richfelker/delta-ballcup/(commit log)

2025-03-15 initial check-in, matching early-access version of the ball-cup file
    [ballcupend.scad]
2025-03-15 fix wrong parameterizations in terms of custom ball cup outer diameter
    aside from the sqrt(2) term, where the old value was very close and
    should have matched but was probably a sloppy empirical determination,
    these changes should not affect the output with the existing default
    od=13.
    [ballcupend.scad]
2025-03-15 make thickness of coverage below ball customizable as angle
    [ballcupend.scad]
2025-03-15 revert cutout parameterization on ball diameter, use fixed value for now
    this will be changed to a proper parameterization, but to start off
    with and have a good point of reference, get rid of the wrong one.
    [ballcupend.scad]
2025-03-15 parameterize clearance cut slope on arm offset and start offset
    [ballcupend.scad]
2025-03-15 add chamfers to end of arm sleeve and arm tube insertion hole
    [ballcupend.scad]
2025-03-15 fixup seam cut above equator
    with a shallow slope, the toroidal seam cut, which doesn't follow the
    cylinder it's cutting, diminishes significantly near the top. add a
    straight one that follows the cylinder.
    this is mainly an aesthetic improvement; the affected part of the seam
    is not a contact point with the ball.
    [ballcupend.scad]
2025-03-15 factor seam cut to module
    [ballcupend.scad]
2025-03-15 round the edge of the seam cut in the cup
    this makes it so not only the seam print quality, but also any
    pressure advance tuning issues, should be irrelevant to the part of
    the cup that comes in contact with the ball.
    the profile used is not perfect because of how it meets the spherical
    curvature of the ball. this is what the 0.9 fudge factor is there for.
    it should be fine for anything but unrealistically small ball sizes,
    but could be tuned further if needed.
    [ballcupend.scad]
2025-03-16 use finer curve refinement parameters
    without this, seam cut comes out with fairly jagged triangles, which
    might affect slicing quality.
    [ballcupend.scad]
2025-03-16 update default parameters to new M45 values
    [ballcupend.scad]
2025-03-20 update default arm diameter with some clearance for easier assembly
    [ballcupend.scad]
2025-04-21 improve chamfer for ease of arm insertion
    [ballcupend.scad]
2025-04-21 add Makefile to generate stl, .gitignore for stl
